saadw50/ultrasound-phased-array-imaging/data/ch01_data.jpg

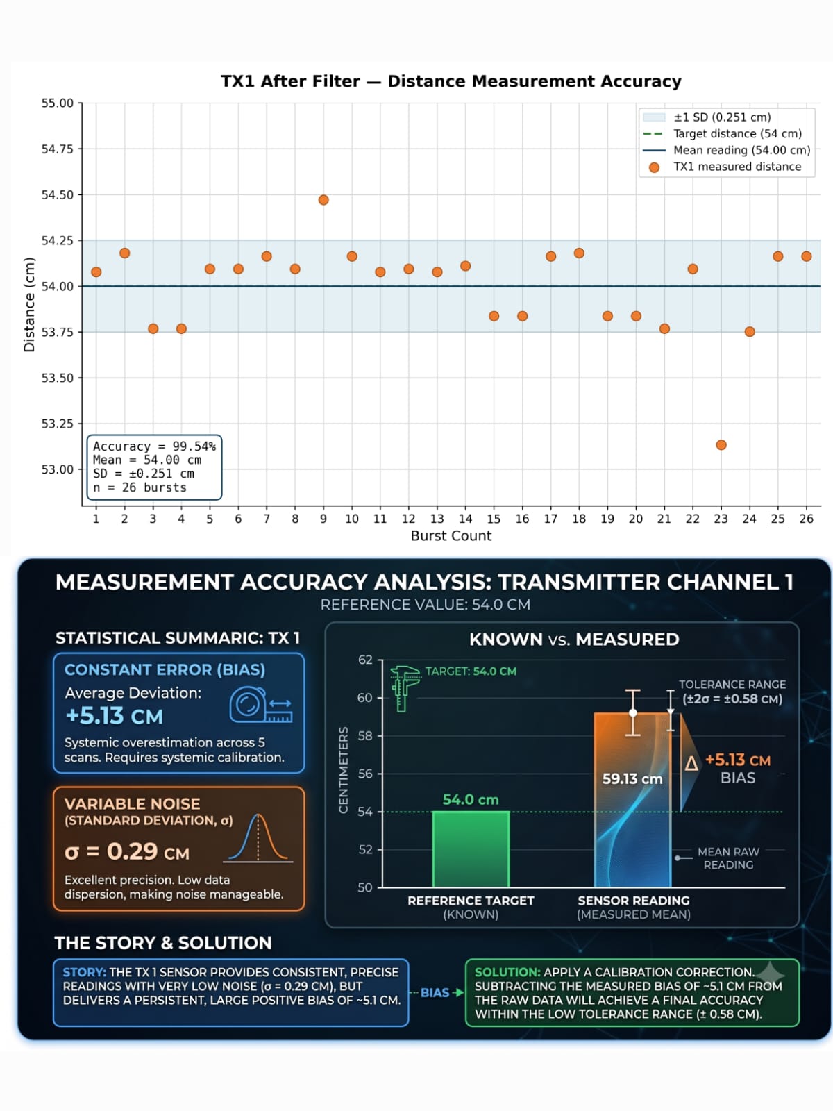
data/ch01_data.jpg
