saadw50/ultrasound-phased-array-imaging/data/object.png

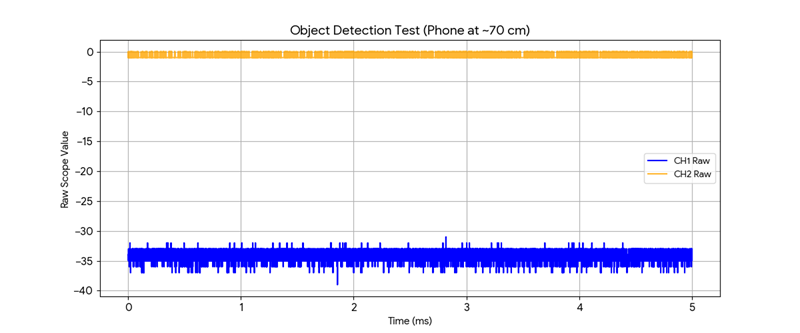
data/object.png
