saadw50/ultrasound-phased-array-imaging/data/Tx vs Rx.png

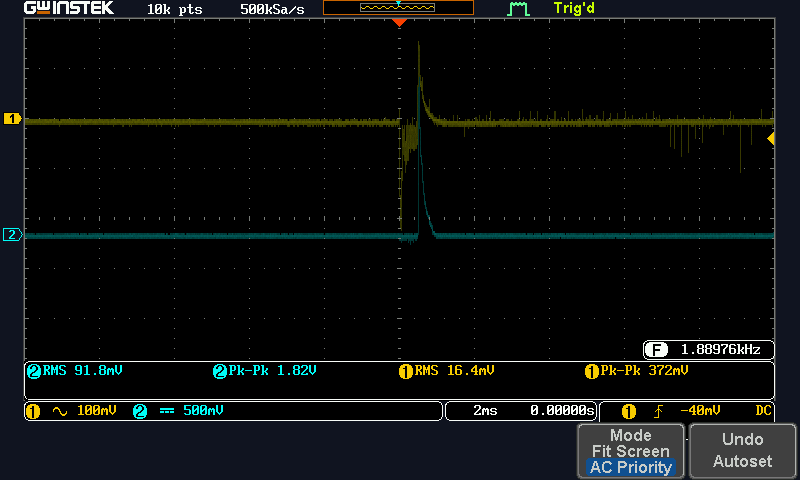
data/Tx vs Rx.png
