saadw50/ultrasound-phased-array-imaging/hardware/PCB.png

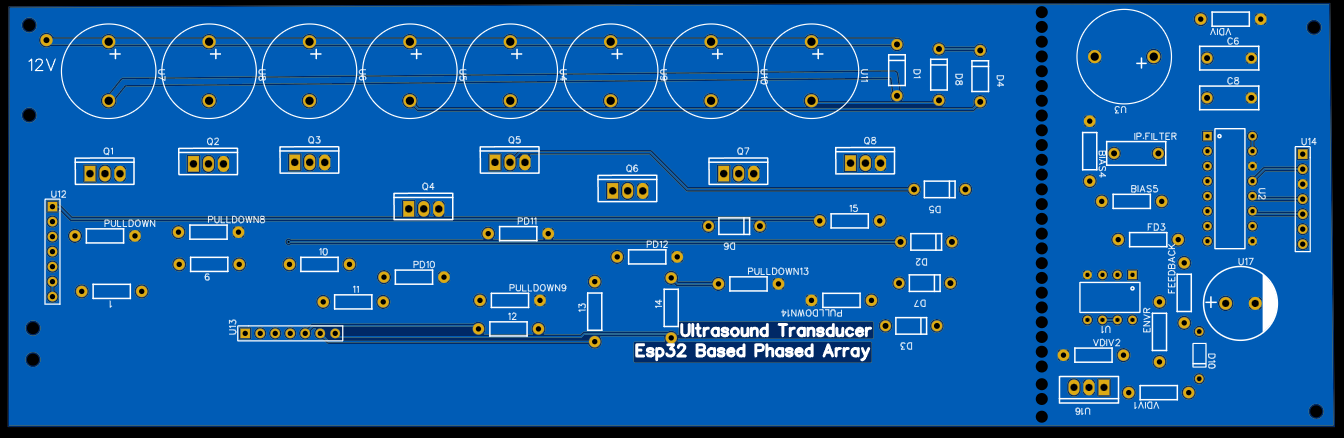
hardware/PCB.png
