saadw50/ultrasound-phased-array-imaging/hardware/rx_design.png

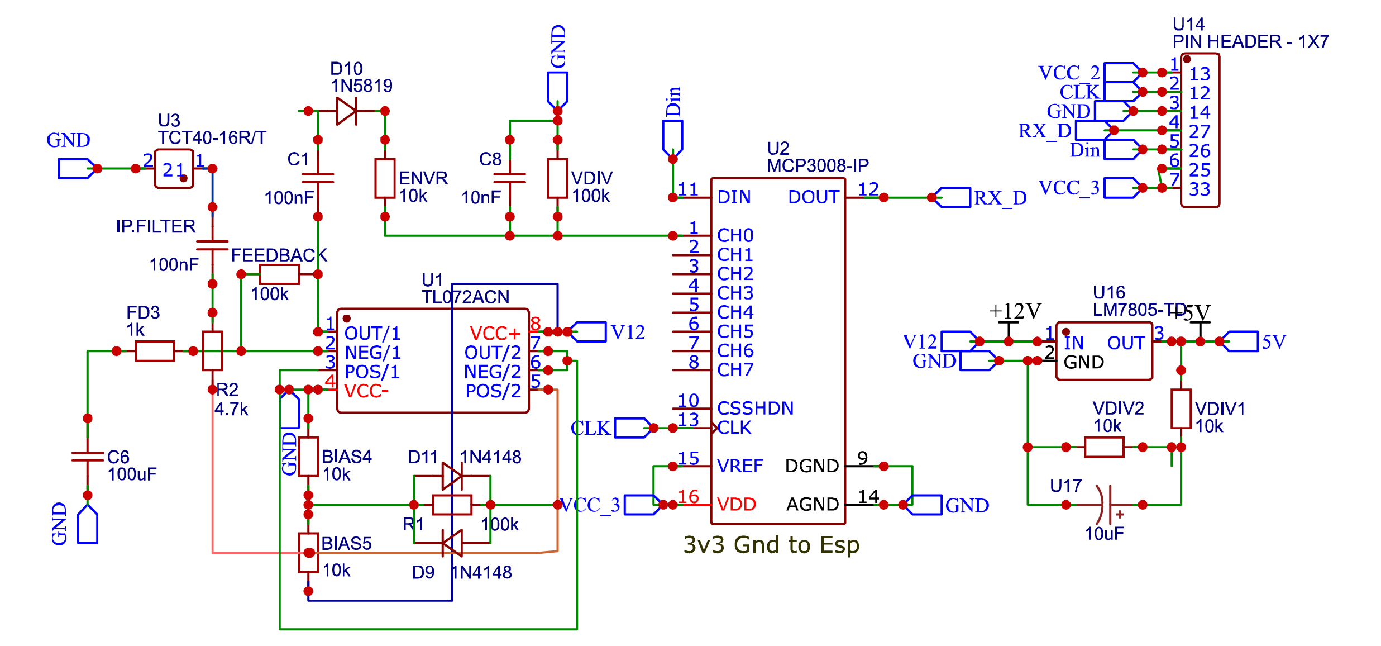
hardware/rx_design.png
