saadw50/ultrasound-phased-array-imaging/hardware/tx_design.png

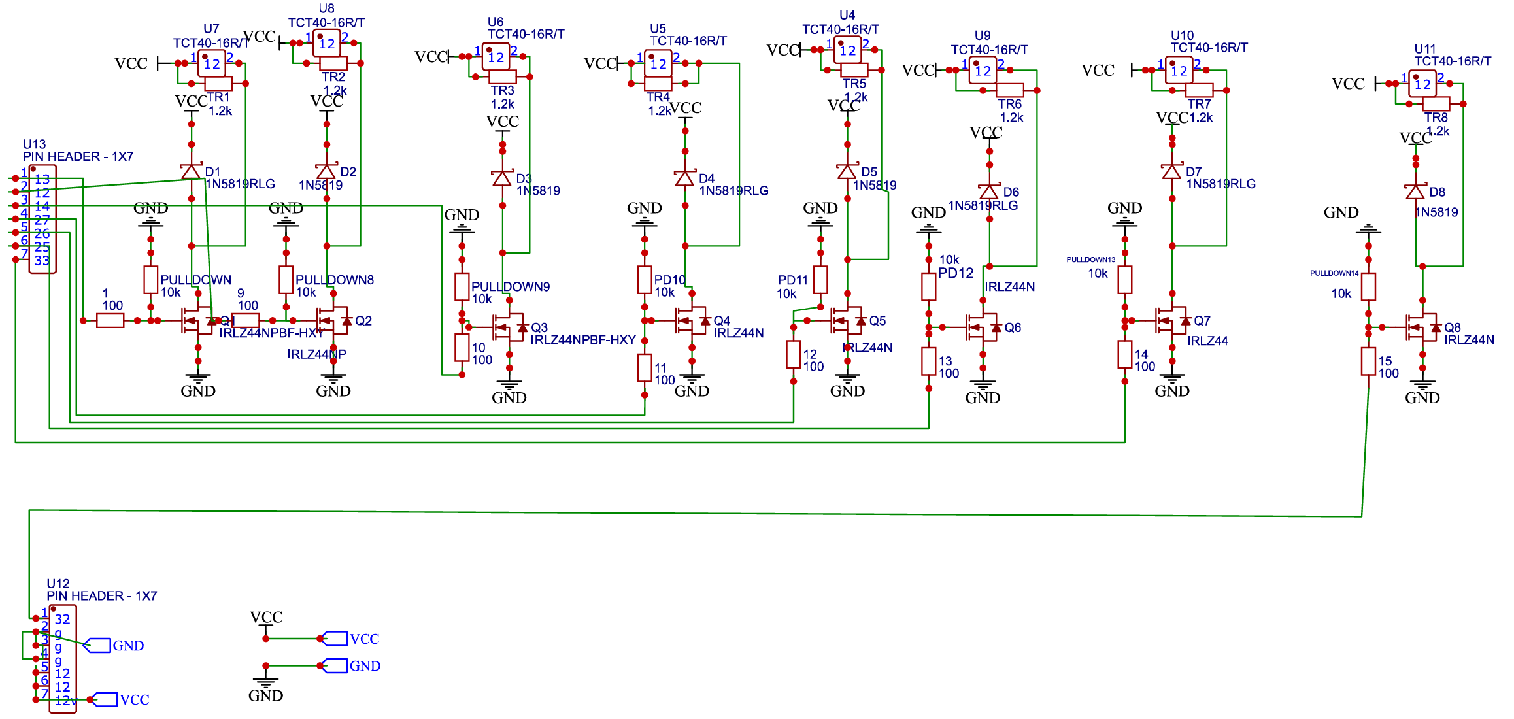
hardware/tx_design.png
