saadw50/ultrasound-phased-array-imaging/results/classification/SESSION_QUALITY_RANKING.csv

grp | session | path | class_label | material | object_id | distance_cm | physical_yaw_deg | tx_mode | gate_start_us | gate_end_us | burst_cycles_requested | sample_rate_requested_hz | sample_count_requested | pretrigger_requested_us | firmware | created_local | n_raw_files | manifest | n_cap | n_angles | ang_min | ang_max | ang_step_med | ang_step_uniform | rep_min | rep_max | rep_med | crc_ok_frac | n_crc_fail | clip_lo | clip_hi | adc_min_min | adc_max_max | n_sat_lo | n_sat_hi | base_std_med | pk_med | rms_med | cf_med | gz_med | pkt_med | p2p_med | en_med | base_std_iqr | snr_db_med | snr_db_p10 | snr_db_p90 | pkt_cv_med | pkt_cv_max | pkt_sd_med_us | pk_ang_min | pk_ang_max | pk_ang_contrast_db | pk_cv_med | gate_start_m | gate_end_m | frac_pin_start | frac_pin_end | txref_us
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
