saadw50/ultrasound-phased-array-imaging/results/imaging/2dzoom_78-85objraw_data.png

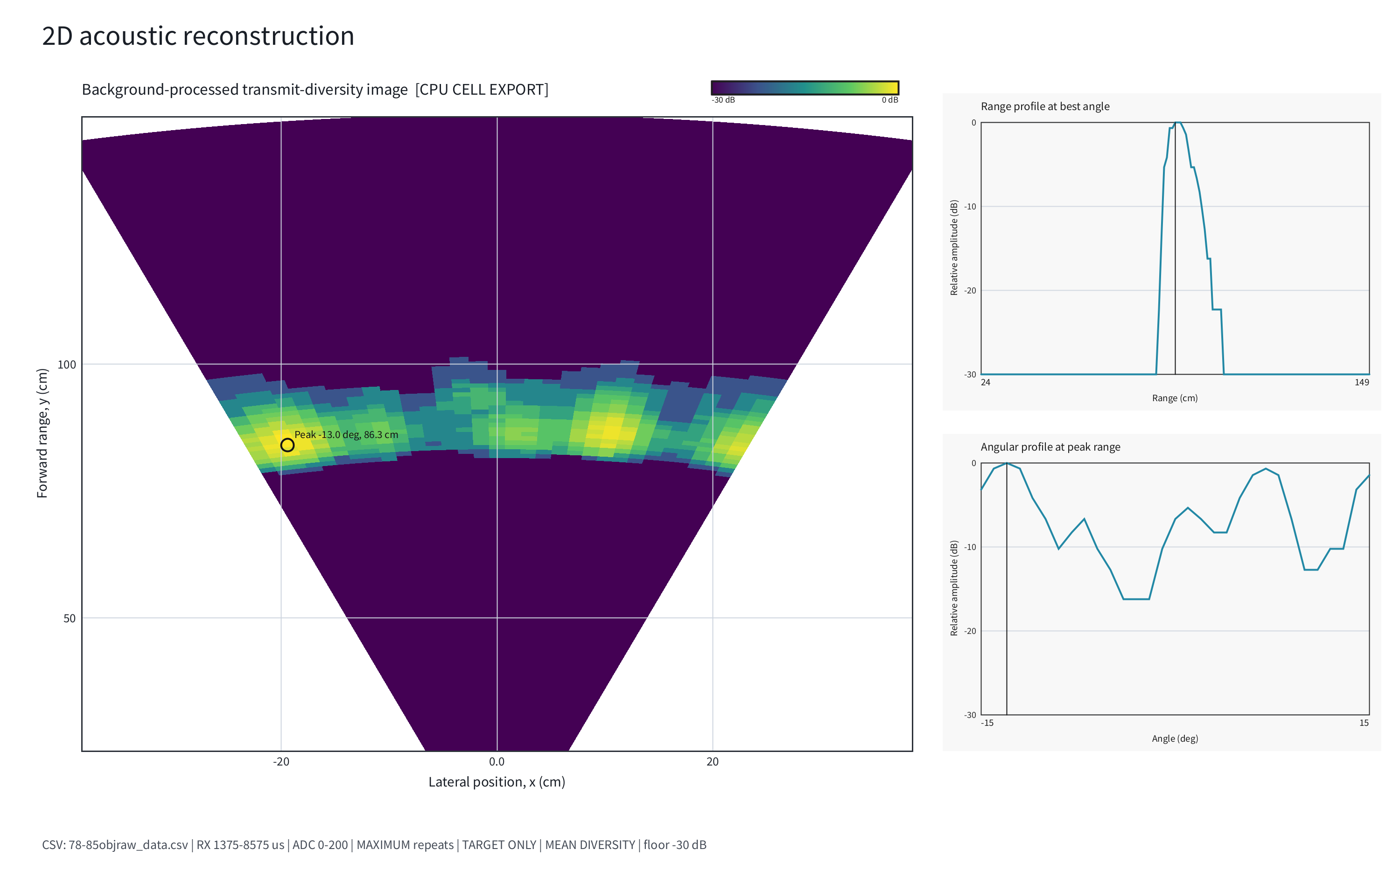
results/imaging/2dzoom_78-85objraw_data.png
