saadw50/ultrasound-phased-array-imaging/results/imaging/84.5cm2d_acoustic.png

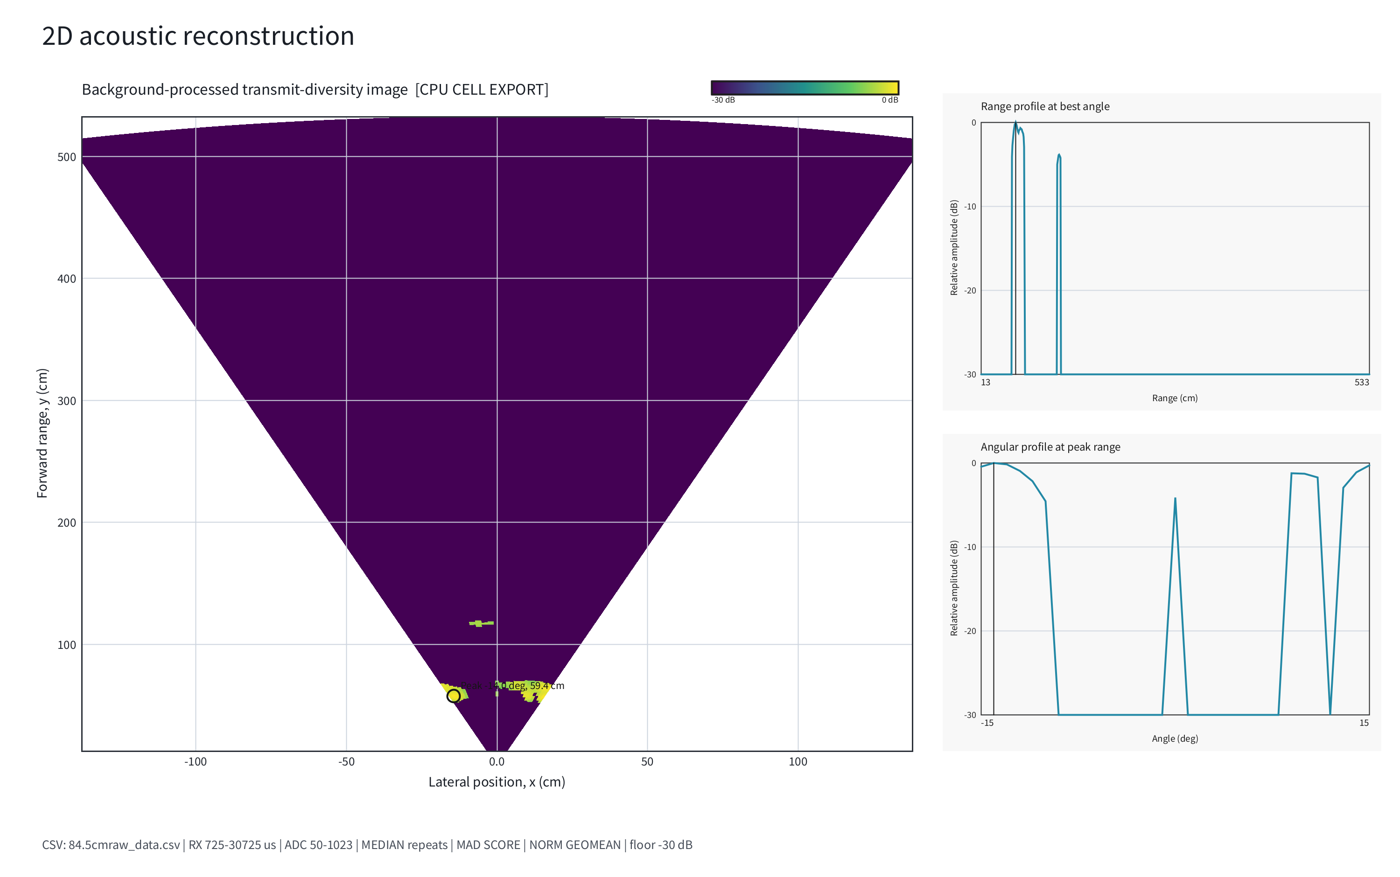
results/imaging/84.5cm2d_acoustic.png
