saadw50/ultrasound-phased-array-imaging/results/imaging/objacoustic_2d_figure.png

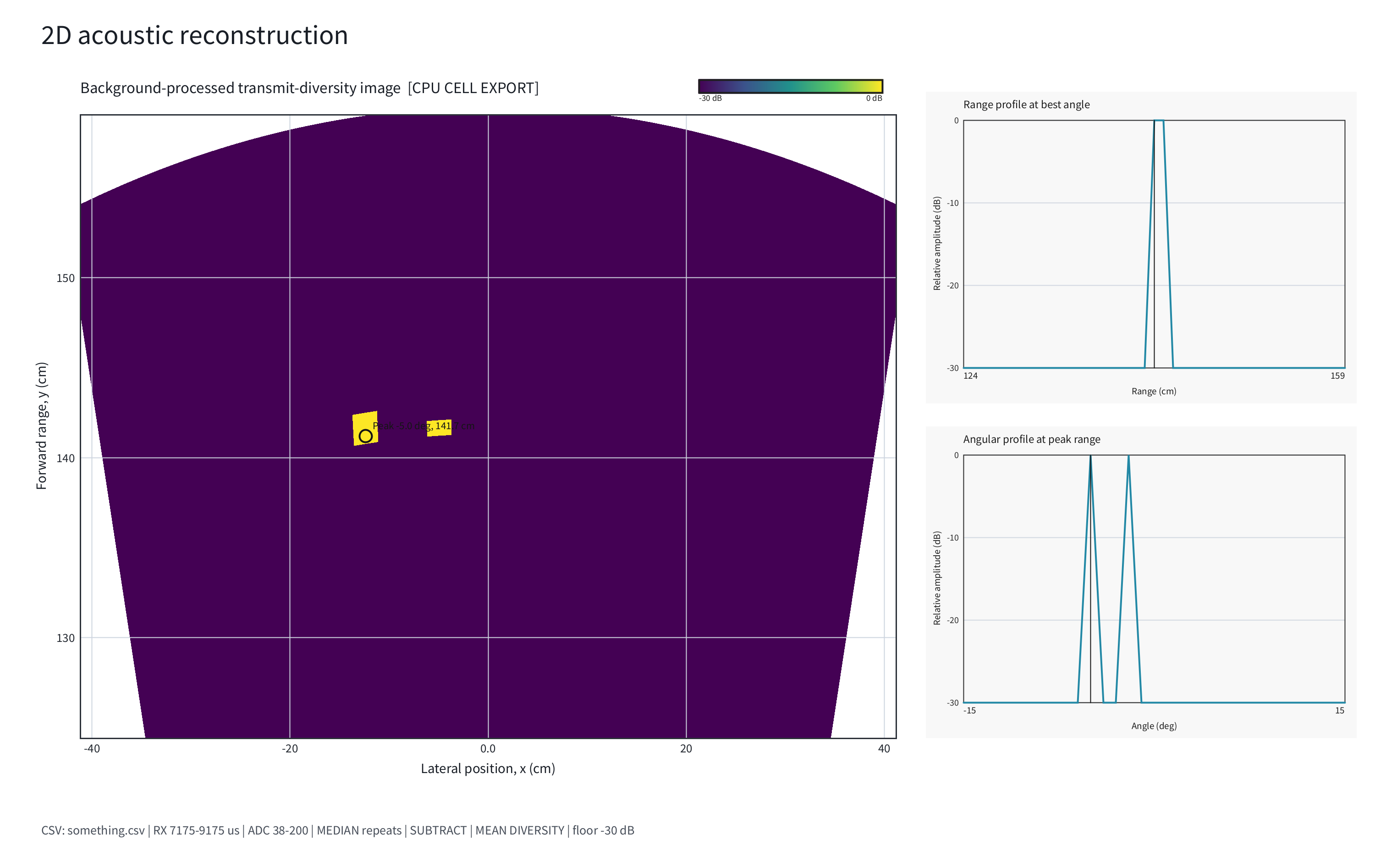
results/imaging/objacoustic_2d_figure.png
